kein5830/PicoTracer/写真/IMG_1227.JPG

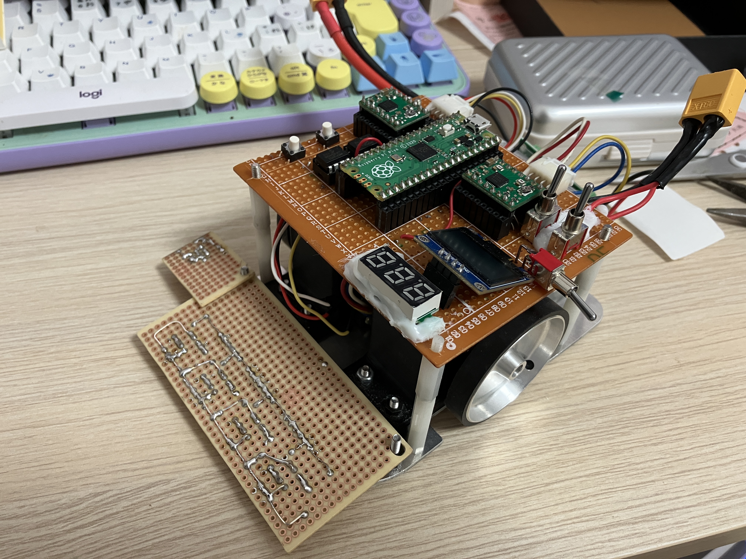
写真/IMG_1227.JPG
