kein5830/PicoTracer/部品リスト.txt

＠メイン基板
・raspi pico(マイコン)
・a4988(モータードライバ)
・MCP3002(AD変換器)×２
・トグルスイッチ（足5本）×３
・プッシュスイッチ(足４本)
・SSD1306(LCDディスプレイ　横長足４本)
・RJ-45Lanコネクタ変換基盤（横長足８本）
・モーター線用コネクタ（多分JST-XHの足４本）×２
・バッテリー電圧入力端子２本（12V,GND）
・DCDCコンバータ用端子４本(12VGND   5VGND)

＠センサー基盤
・フォトリフレクタ黒のやつ（足４本）×５個
・抵抗220Ω×5個
・抵抗10kΩ×5個

変更点

GP16、GP17：プッシュスイッチ⇒　OLEDディスプレイ
GP18、GP19：割り当てなし⇒　プッシュスイッチ

追加

ブザー
リセット用スイッチ

・仕様
電圧計は採用せず、raspi picoのAD変換機能で測定し、できればディスプレイ表示かLED３つくらいつけて一定電圧以下になったら消灯していくイメージで電圧表示
