kein5830/PicoTracer/写真/スクリーンショット 2024-08-12 18.56.13.png

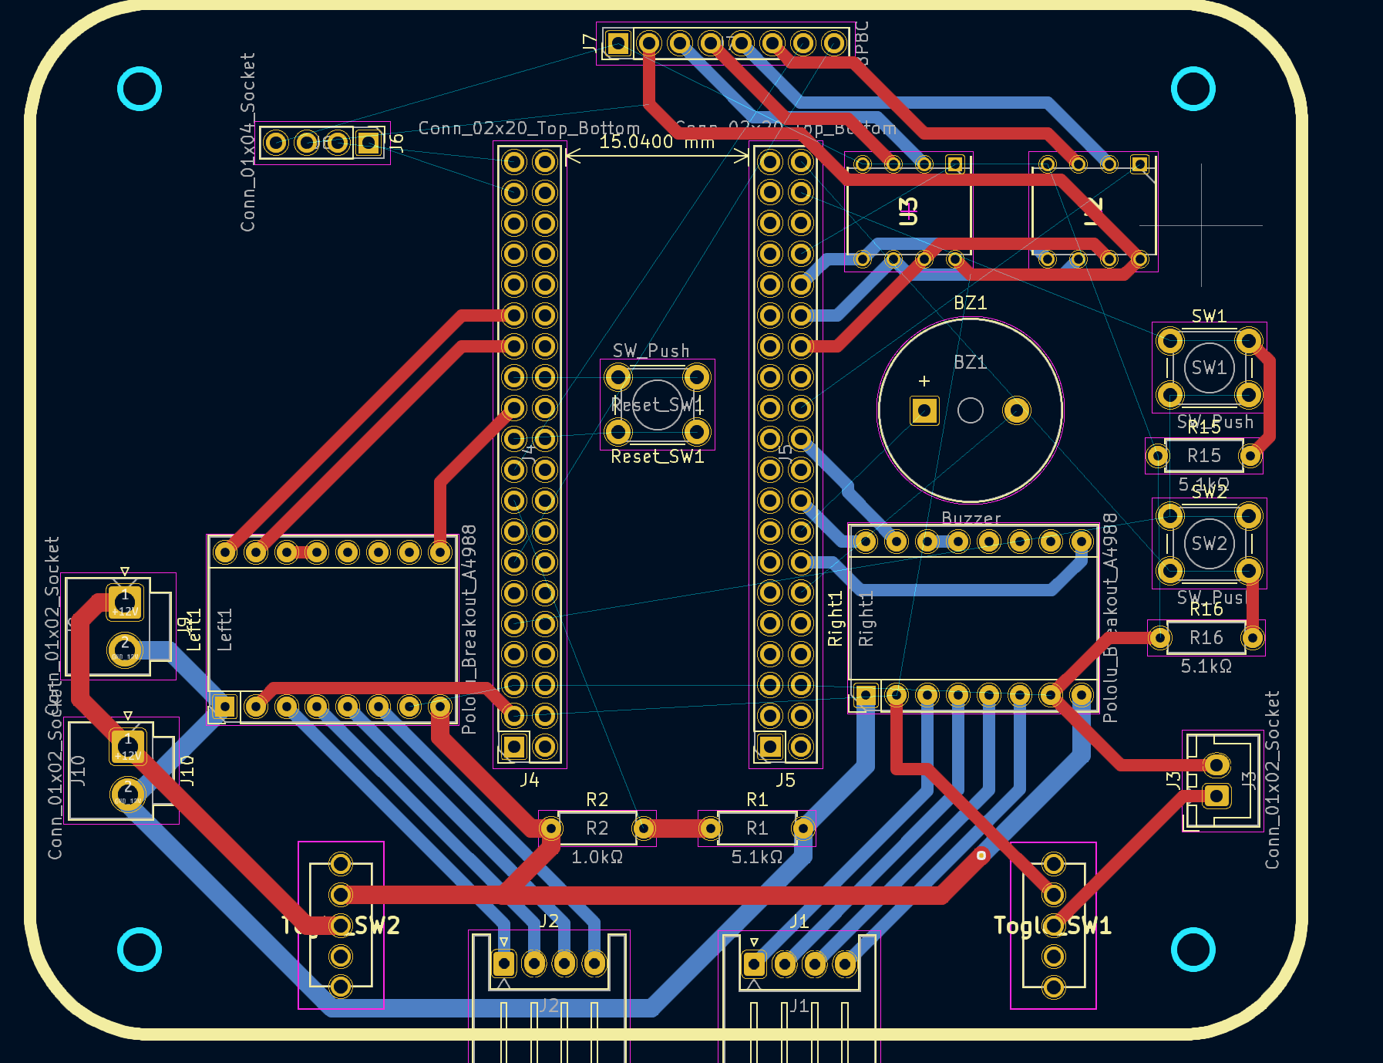
写真/スクリーンショット 2024-08-12 18.56.13.png
