kein5830/PicoTracer/写真/スクリーンショット 2024-08-13 20.15.27.png

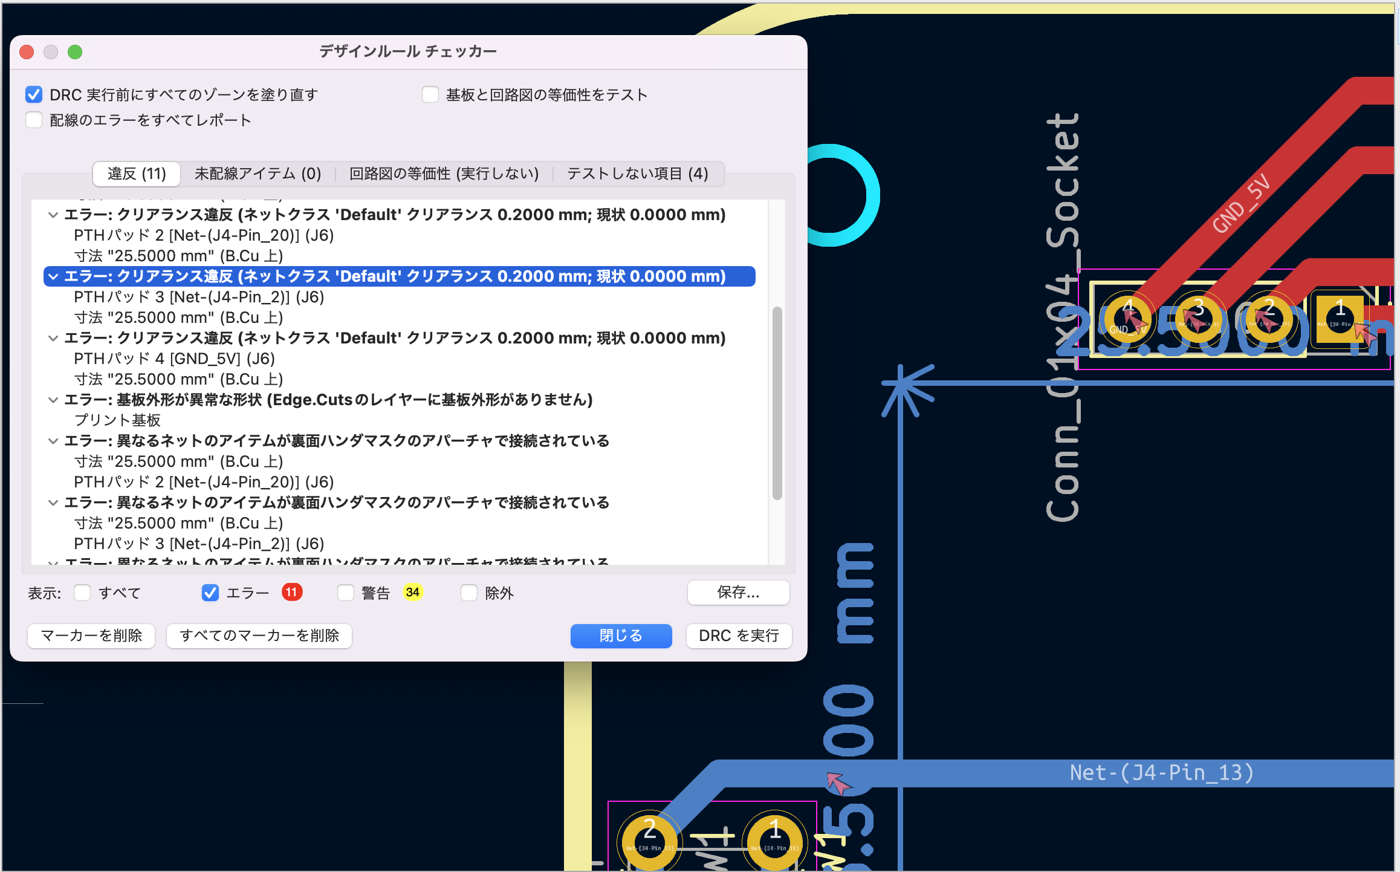
写真/スクリーンショット 2024-08-13 20.15.27.png
