kein5830/PicoTracer/circuit/PicoTracer.kicad_pcb

## KiCad design circuit/PicoTracer.kicad_pcb (2024-11-11, last stored version)

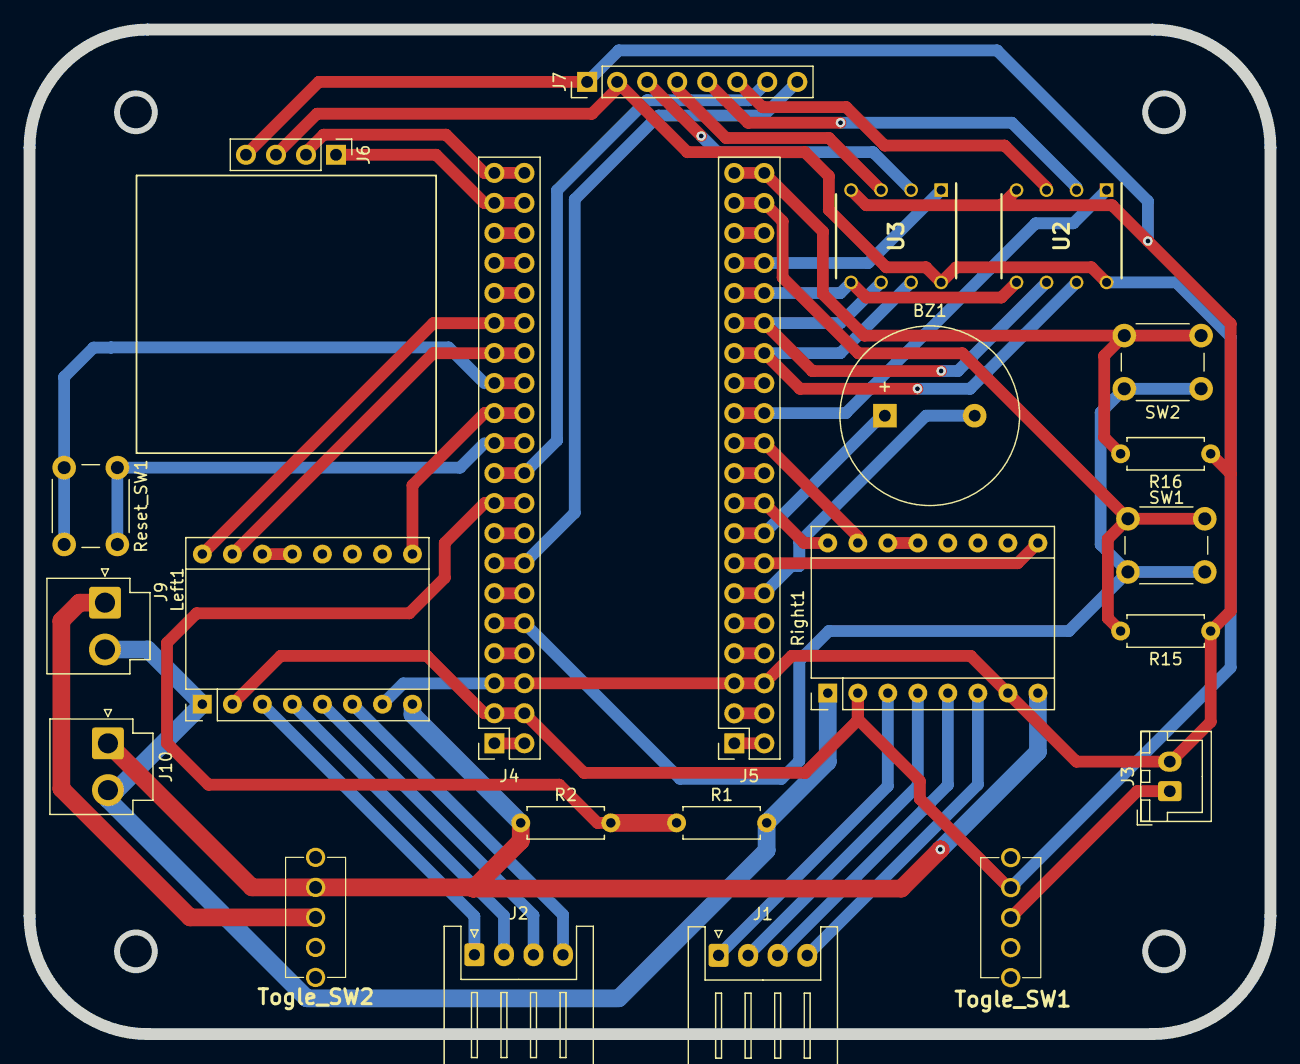
[picture p6: board PicoTracer.kicad_pcb from above]

Board: 2 copper layers, 105.0 x 85.0 mm, 23 parts (0 on the bottom side), 57 nets.

Parts:
BZ1: Buzzer; Buzzer_15x7.5RM7.6
J1, J2: Conn_01x04_Socket; JST_XH_S4B-XH-A_1x04_P2.50mm_Horizontal
J3: Conn_01x02_Socket; JST_XH_B2B-XH-A_1x02_P2.50mm_Vertical
J4, J5: Conn_02x20_Top_Bottom; PinSocket_2x20_P2.54mm_Vertical_Raspipico
J6: Conn_01x04_Socket; PinHeader_1x04_P2.54mm_Vertical
J7: 8P8C; PinHeader_1x08_P2.54mm_Vertical
J9, J10: Conn_01x02_Socket; JST_VH_B2P-VH_1x02_P3.96mm_Vertical
Left1: Pololu_Breakout_A4988; Pololu_Breakout-16_15.2x20.3mm
R1, R15, R16: 5.1kΩ; R_Axial_DIN0207_L6.3mm_D2.5mm_P7.62mm_Horizontal
R2: 1.0kΩ; R_Axial_DIN0207_L6.3mm_D2.5mm_P7.62mm_Horizontal
Reset_SW1: SW_Push; SW_PUSH_6mm_H4.3mm
Right1: Pololu_Breakout_A4988; Pololu_Breakout-16_15.2x20.3mm
SW1, SW2: SW_Push; SW_PUSH_6mm_H4.3mm
Togle_SW1, Togle_SW2: SW_SPDT; 2MS1T1B4VS2QES
U2, U3: MCP3002; DIP781W56P254L950H533Q8N

Connections:
3.3V: J4.5, J4.25, SW1.2, SW2.1
+5V: J3.1, Togle_SW1.2 (B)
+12V: J9.1, Togle_SW2.2 (B)
Clock: J5.14, J5.34, U2.7 (CLK), U3.7 (CLK)
Curve_Sensor: J4.7, J4.27, J7.8
Din: J5.16, J5.36, U2.5 (DIN), U3.5 (DIN)
Dout: J5.15, J5.35, U2.6 (DOUT), U3.6 (DOUT)
GND_5V: J3.2, J4.3, J4.23, J5.3, J5.23, J6.4, J7.1, Left1.7 (GND), R15.1, R16.1, Right1.7 (GND), U2.4 (VSS), U3.4 (VSS)
GND_12V: J9.2, J10.2, Left1.1 (GND), R1.2, Right1.1 (GND)
Goal_Sensor: J4.10, J4.30, J7.7
Left_Direction: J4.15, J4.35, Left1.16 (DIR)
Left_Enable: J4.12, J4.32, Left1.9 (~ENABLE)
Left_Step: J4.14, J4.34, Left1.15 (STEP)
unnamed: BZ1.1 (+), J5.8, J5.28
unnamed: BZ1.2 (-), J5.6, J5.26
unnamed: J1.1, Right1.3 (1B)
unnamed: J1.2, Right1.4 (1A)
unnamed: J1.3, Right1.5 (2A)
unnamed: J1.4, Right1.6 (2B)
unnamed: J2.1, Left1.3 (1B)
unnamed: J2.2, Left1.4 (1A)
unnamed: J2.3, Left1.5 (2A)
unnamed: J2.4, Left1.6 (2B)
unnamed: J4.1, J4.21
unnamed: J4.2, J4.22, J6.3, J7.2, Left1.2 (VDD), Right1.2 (VDD), Togle_SW1.1 (A), U2.8 (VDD/VREF), U3.8 (VDD/VREF)
unnamed: J4.11, J4.31, Reset_SW1.1
unnamed: J4.13, J4.33, Reset_SW1.2
unnamed: J4.16, J4.36
unnamed: J4.17, J4.37
unnamed: J4.18, J4.38
unnamed: J4.19, J4.39, J6.1
unnamed: J4.20, J4.40, J6.2
unnamed: J4.4, J4.24
unnamed: J4.6, J4.26
unnamed: J4.8, J4.28
unnamed: J4.9, J4.29, R1.1, R2.2
unnamed: J5.1, J5.21
unnamed: J5.2, J5.22
unnamed: J5.10, J5.30
unnamed: J5.13, J5.33
unnamed: J5.18, J5.38
unnamed: J5.19, J5.39, R15.2, SW1.1
unnamed: J5.20, J5.40, R16.2, SW2.2
unnamed: J5.4, J5.24
unnamed: J5.5, J5.25
unnamed: J10.1, Left1.8 (VMOT), R2.1, Right1.8 (VMOT), Togle_SW2.1 (A)
unnamed: Left1.13 (~RESET), Left1.14 (~SLEEP)
unnamed: Right1.13 (~RESET), Right1.14 (~SLEEP)
unnamed: J7.5, U2.2 (CH0)
unnamed: J7.6, U2.3 (CH1)
unnamed: J7.3, U3.2 (CH0)
unnamed: J7.4, U3.3 (CH1)
Right_Direction: J5.9, J5.29, Right1.16 (DIR)
Right_Enable: J5.7, J5.27, Right1.9 (~ENABLE)
Right_Step: J5.11, J5.31, Right1.15 (STEP)
Sel1: J5.12, J5.32, U2.1 (~CS/SHDN)
Sel2: J5.17, J5.37, U3.1 (~CS/SHDN)
