kein5830/PicoTracer/circuit/PicoTracer_Sensor.kicad_pcb

## KiCad design circuit/PicoTracer_Sensor.kicad_pcb (2024-11-11, last stored version)

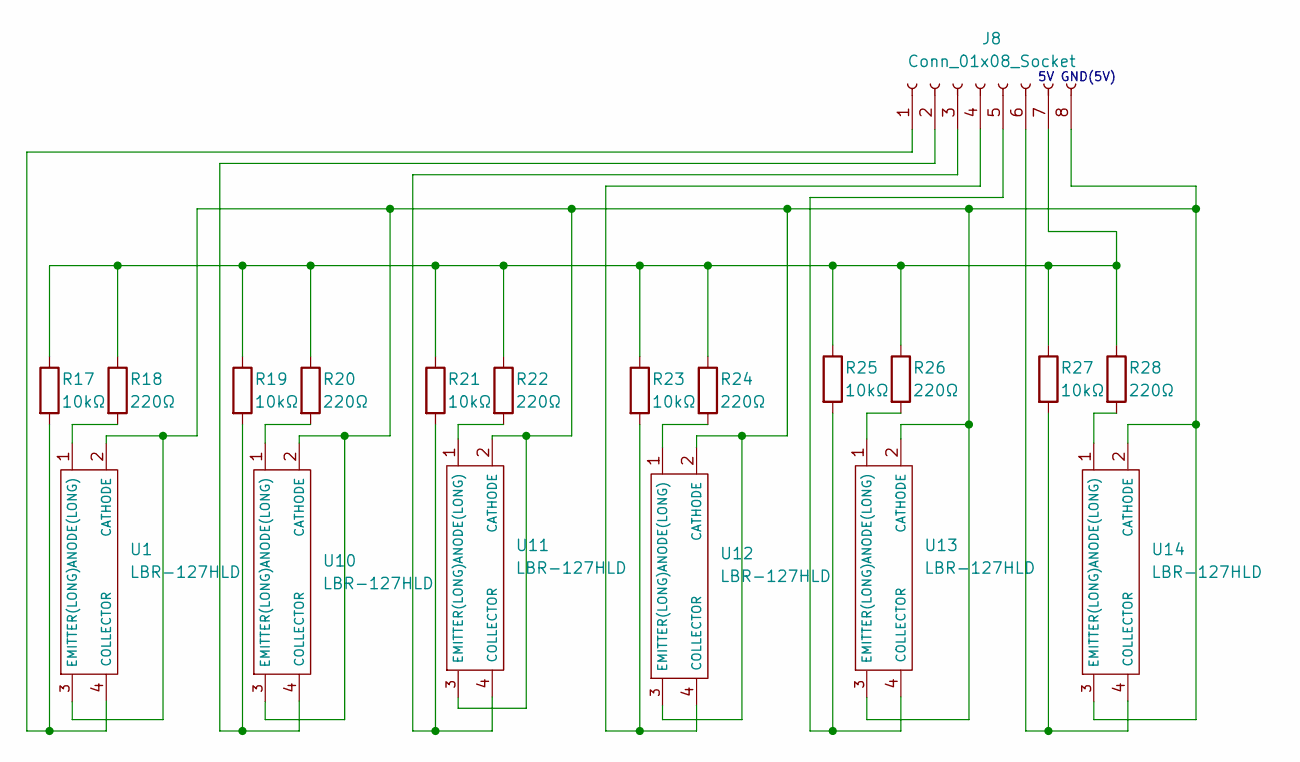
[picture p7: schematic PicoTracer_Sensor.kicad_sch]

Parts:
J8: Conn_01x08_Socket; PinSocket_1x08_P2.54mm_Vertical
R17, R19, R21, R23, R25, R27: 10kΩ; R_Axial_DIN0207_L6.3mm_D2.5mm_P7.62mm_Horizontal
R18, R20, R22, R24, R26, R28: 220Ω; R_Axial_DIN0207_L6.3mm_D2.5mm_P7.62mm_Horizontal
U1, U10, U11, U12, U13, U14: LBR-127HLD; LBR127HLD; Manufacturer_Part_Number LBR-127HLD

Connections:
unnamed: J8.1, R17.2, U1.4 (COLLECTOR)
unnamed: J8.2, R19.2, U10.4 (COLLECTOR)
unnamed: J8.3, R21.2, U11.4 (COLLECTOR)
unnamed: J8.4, R23.2, U12.4 (COLLECTOR)
unnamed: J8.5, R25.2, U13.4 (COLLECTOR)
unnamed: J8.6, R27.2, U14.4 (COLLECTOR)
unnamed: J8.7, R17.1, R18.1, R19.1, R20.1, R21.1, R22.1, R23.1, R24.1, R25.1, R26.1, R27.1, R28.1
unnamed: J8.8, U1.2 (CATHODE), U1.3 (EMITTER(LONG)), U10.2 (CATHODE), U10.3 (EMITTER(LONG)), U11.2 (CATHODE), U11.3 (EMITTER(LONG)), U12.2 (CATHODE), U12.3 (EMITTER(LONG)), U13.2 (CATHODE), U13.3 (EMITTER(LONG)), U14.2 (CATHODE), U14.3 (EMITTER(LONG))
unnamed: R18.2, U1.1 (ANODE(LONG))
unnamed: R20.2, U10.1 (ANODE(LONG))
unnamed: R22.2, U11.1 (ANODE(LONG))
unnamed: R24.2, U12.1 (ANODE(LONG))
unnamed: R26.2, U13.1 (ANODE(LONG))
unnamed: R28.2, U14.1 (ANODE(LONG))

Notes on the sheet:
GND(5V)

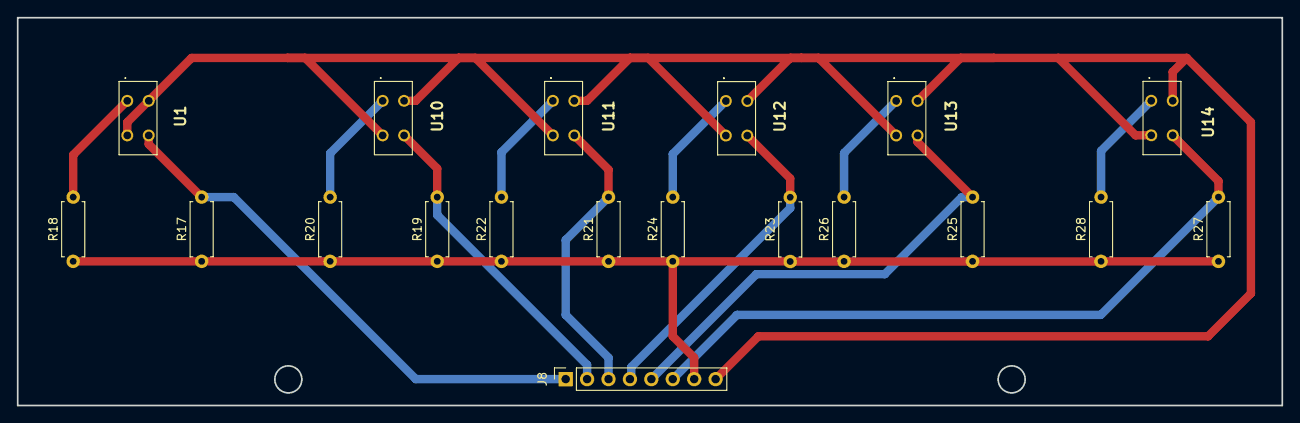
[picture p8: board PicoTracer_Sensor.kicad_pcb from above]

Board: 2 copper layers, 150.0 x 46.0 mm, 19 parts (0 on the bottom side), 14 nets.
