kein5830/PicoTracer/soucecode/picotracer/Scene3.ino

//構造体インクルード
#include "types.h"

//---------------------------------------------------------------------
//@fn　走行関数Scene3
//@brief ライントレース走行
//@param なし
//@return void
//@details　PI制御　スタート時のゆっくり加速あり+0.35 最高速度800
//---------------------------------------------------------------------
void Scene3() {
//*******************************************************************
  //メイン走行スピード、PIDのゲイン値、その他ローカル変数定義
  //*******************************************************************
  //初期
    static uint16_t tmp_distance = 0;
    static uint32_t temp_distance2 = 1;
    static int tmporary = 0;
  if(c == 0){
    //基準速度
    interval_tar = 250;
    //Pゲイン
    pgain = 0.3;
    //Dゲイン
    dgain = 0;
    //Iゲイン
    igain = 0.0;
    
    //臨時措置＃＃＃＃＃＃＃＃＃＃＃＃＃＃＃＃＃＃＃＃＃＃＃＃＃＃＃＃＃＃＃＃＃＃＃＃＃＃＃＃＃＃＃＃＃＃＃ 
    marker_distance[0] = 	5306;
    marker_distance[1] = 	386;
    marker_distance[2] = 	192;
    marker_distance[3] = 	301;
    marker_distance[4] = 	185;
    marker_distance[5] = 	292;
    marker_distance[6] = 	187;
    marker_distance[7] = 	297;
    marker_distance[8] = 	185;
    marker_distance[9] = 	422;
    marker_distance[10] = 	393;
    marker_distance[11] = 	628;
    marker_distance[12] = 	239;
    marker_distance[13] = 	213;
    marker_distance[14] = 	113;
    marker_distance[15] = 	202;
    marker_distance[16] = 	109;
    marker_distance[17] = 	206;
    marker_distance[18] = 	105;
    marker_distance[19] = 	202;
    marker_distance[20] = 	255;
    marker_distance[21] = 	182;
    marker_distance[22] = 	285;
    marker_distance[23] = 	484;
    marker_distance[24] = 	235;
    marker_distance[25] = 	502;
    marker_distance[26] = 	1351;
    marker_distance[27] = 	7;
    marker_distance[28] = 	1181;
    marker_distance[29] = 	443;
    marker_distance[30] = 	337;
    marker_distance[31] = 	312;
    marker_distance[32] = 	1145;
    marker_distance[33] = 	422;
    marker_distance[34] = 	924;
    marker_distance[35] = 	768;
    marker_distance[36] = 	1237;
    marker_distance[37] = 	353;
    marker_distance[38] = 	885;
    marker_distance[39] = 	128;
    marker_distance[40] = 	135;
    marker_distance[41] = 	138;
    marker_distance[42] = 	190;
    marker_distance[43] = 	190;
    marker_distance[44] = 	186;
    marker_distance[45] = 	481;
    marker_distance[46] = 	1008;
    marker_distance[47] = 	247;
    marker_distance[48] = 	374;
    marker_distance[49] = 	289;
    marker_distance[50] = 	283;
    marker_distance[51] = 	249;
    marker_distance[52] = 	1192;
    marker_distance[53] = 	178;
    marker_distance[54] = 	74;
    marker_distance[55] = 	979;
    marker_distance[56] = 	343;
    marker_distance[57] = 	1182;
    marker_distance[58] = 	248;
    marker_distance[59] = 	140;
    marker_distance[60] = 	141;
    marker_distance[61] = 	341;
    marker_distance[62] = 	164;
    marker_distance[63] = 	219;
    marker_distance[64] = 	901;
    marker_distance[65] = 	334;
    marker_distance[66] = 	1560;
    marker_distance[67] = 	233;
    marker_distance[68] = 	234;
    marker_distance[69] = 	186;
    marker_distance[70] = 	67;
    //臨時措置 大会時は削除する（コースの記録）＃＃＃＃＃＃＃＃＃＃＃＃＃＃＃＃＃＃＃＃＃＃＃＃＃＃＃＃＃＃＃＃＃＃＃＃＃＃＃＃＃＃＃＃＃＃＃
    //最速走行のマーカ確認
    for(int z=0;z<=first_count;z++){
      Serial.print("marker_distance：");
      Serial.println(marker_distance[z]);
    }
    c=1;
  }
  pgain = 0.3;

  //*******************************************************************
  //センサー値格納　（202412月17日に配置更新）
  //*******************************************************************
  sensorCurve = analogRead(Curve_Sensor);
  sensorLL = read_adc(ch1, SELPIN1);
  sensorL = read_adc(ch0, SELPIN1);
  sensorR = read_adc(ch1, SELPIN2);
  sensorRR = read_adc(ch0, SELPIN2);
  sensorGoal = analogRead(GOALSENSOR);

  //必要であれば
  // Serial.print(marker_distance[curve_count], DEC);
  // Serial.print(" ");
  // Serial.print(NowDistance, DEC);
  // Serial.print(" ");
  // Serial.print(temp_distance2, DEC);
  // Serial.print(" "); 
  // Serial.print(curve_count, DEC);
  // // Serial.print(" ");
  // // Serial.print(sensorRR, DEC);
  // // Serial.print(" ");
  // // Serial.print(sensorGoal, DEC);
  // Serial.println(" ");

  //*******************************************************************
  //ラインカウンタ制御  
  //*******************************************************************
  //クロスラインを検知したら、クロスフラグをON
  if (tmpc == 0 && sensorL < 300 && sensorR < 300 && sensorLL < 300 && sensorRR < 300) {
    temp_distance = NowDistance;
    cross = 1;
    tmpc = 1;
    }
  if ( tmpc == 1 && sensorLL > 700 && sensorRR > 700) {
    tmpc = 0;
  }

  //ゴールセンサが検知したらtmpフラグをON
  if (tmp == 0 && sensorGoal < 300 ){  //速度によって調整  && sensorRR > 500 && sensorLL > 500 && Curve > 800
    if(cross != 1){
      count++;
      //BUZZER入れたが音小さくて聞こえない
      tone(BUZZER,1178,100);
      // StepSW = !StepSW;
    }
    tmp = 1;
  }
  //ゴールセンサが検知しなくなったらクロスフラグを確認し、ゴールマーカーを追加するか判断
  if (tmp == 1 && sensorGoal > 700) {
    tmp = 0;
  }

  //カーブマーカー検知
  if (curve_temp == 0  && sensorCurve < 300){
      //クロスではない場合
      if(cross != 1){
        curve_count++;      
        //BUZZER入れたが音小さくて聞こえない
        tone(BUZZER,1178,100);
        }
      curve_temp = 1;
  }
  
  if (sensorCurve > 700) { 
    curve_temp = 0;
  }
  //クロス検知後から35mm進んだらおそらくゴール、カーブセンサは過ぎてるだろうからクロスフラグを戻す（誤検知する場合は調整する）
  if((NowDistance-temp_distance) >= 43){
    cross = 0;
  }

  //ゴール後処理
  if (count == 2) {
    if (b == 0) {
      //最後のマーカからゴールまでの距離を保存する
      // marker_distance[curve_count] = NowDistance - tmp_distance;
      // //タイマースタート処理
      // ITimer0.stopTimer();
      // ITimer0.attachInterrupt(100, callback0);  //自宅コースはスタートエリアが狭いため一時的に無効化し即停止するようにしている
      interval_tar = 0;
      first_count = curve_count;
      Step = 0;
    }
    b=1;
    
  }
  if (count >= 2 && interval < 10) {  //停止位置は試走会で調整
      ITimer0.stopTimer();
      ITimer1.stopTimer();
      Reset();
      Run = 0;

      tone(BUZZER,1446,1000); 
    }
  //ライン制御
  // Add_SensorL = sensorL + sensorLL;
  // Add_SensorR = sensorR + sensorRR;

  //加減速モード（基本的に800以上のところで加減速することになる。）
  if(marker_distance[curve_count] > 1000){
    pgain = 0.1;
    static bool first = 0;
    if(first == 0){
    temp_distance2 = NowDistance;
    first = 1;
    }
    if(prev_curve_count != curve_count){
      temp_distance2 = NowDistance;
    }
    // 記録されている距離ー加速モードに入ってからの距離＝400を切ったら減速していく
    tmporary =  (marker_distance[curve_count])-(NowDistance - temp_distance2);
    if(tmporary < 400){
      interval_tar = 300;
      // Serial.print("減速開始");
    }else{
      interval_tar = 999;
    }

    prev_curve_count = curve_count;
  }

  //今回の差分
  diff = (sensorL + sensorLL) - (sensorR + sensorRR) - bias;  //biasは試走会で調整

  //-50~50なら差分なしとする
  if(diff<=400 && diff>=-400){
    diff=0;
  }
  //  Serial.print("diff:");
  //  Serial.print(diff);
  sum += diff;
  //P制御
  P = diff * pgain;
  //D制御
  D = (beforediff - diff) * dgain;
  //I制御
  I = sum * igain;
  //入力速度にPID制御値を代入
  //Dを-にしてPで発生するオーバーシュートを抑える形にすることも検討
  PID_Result = P + D + I;
  // inputR = SP - (P + D + I);

 // 加減速時のみPIDの値に制限をかける
 if(pgain == 0.1){
  if(PID_Result < -200){
    PID_Result = -200;
  }
  if(PID_Result > 200){
    PID_Result = 200;
  }
 }

  //前回の差分を保存き
  beforediff = diff;

  //クロス通過時は速度を固定する
  if (sensorLL < 400 && sensorRR < 400) {
    PID_Result = 0;
  }



  //ログ保存スタートボタンを押してから
    // data_log[log_count].Curve_log = sensorCurve;
    // data_log[log_count].LL_log = curve_count;
    // data_log[log_count].L_log = NowDistance;
    // data_log[log_count].R_log = cross;
    // data_log[log_count].RR_log = temp_distance;
    // data_log[log_count].Goal_log = count;
//    data_log[log_count].R_motor_log = inputR;
//    data_log[log_count].L_motor_log = PID_Result;
    log_count++;  
}
