kein5830/PicoTracer/soucecode/picotracer/AccTable.h

unsigned short AccTable[1000]{
0,36,51,62,72,80,88,95,101,107,
113,119,124,129,134,138,143,147,152,156,
160,164,168,171,175,179,182,186,189,193,
196,199,202,205,208,212,215,217,220,223,
226,229,232,234,237,240,242,245,248,250,
253,255,258,260,263,265,268,270,272,275,
277,279,282,284,286,288,290,293,295,297,
299,301,303,305,308,310,312,314,316,318,
320,322,324,326,328,330,332,333,335,337,
339,341,343,345,347,348,350,352,354,356,
358,359,361,363,365,366,368,370,372,373,
375,377,378,380,382,383,385,387,388,390,
392,393,395,397,398,400,401,403,405,406,
408,409,411,412,414,415,417,418,420,422,
423,425,426,428,429,431,432,433,435,436,
438,439,441,442,444,445,447,448,449,451,
452,454,455,456,458,459,461,462,463,465,
466,468,469,470,472,473,474,476,477,478,
480,481,482,484,485,486,488,489,490,492,
493,494,495,497,498,499,501,502,503,504,
506,507,508,509,511,512,513,514,516,517,
518,519,521,522,523,524,525,527,528,529,
530,532,533,534,535,536,538,539,540,541,
542,543,545,546,547,548,549,550,552,553,
554,555,556,557,558,560,561,562,563,564,
565,566,568,569,570,571,572,573,574,575,
577,578,579,580,581,582,583,584,585,586,
587,589,590,591,592,593,594,595,596,597,
598,599,600,601,603,604,605,606,607,608,
609,610,611,612,613,614,615,616,617,618,
619,620,621,622,623,624,625,626,627,628,
630,631,632,633,634,635,636,637,638,639,
640,641,642,643,644,645,646,647,648,649,
650,650,651,652,653,654,655,656,657,658,
659,660,661,662,663,664,665,666,667,668,
669,670,671,672,673,674,675,676,676,677,
678,679,680,681,682,683,684,685,686,687,
688,689,690,691,691,692,693,694,695,696,
697,698,699,700,701,702,702,703,704,705,
706,707,708,709,710,711,711,712,713,714,
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
};
