kein5830/PicoTracer/soucecode/picotracer/types.h

#include <Arduino.h>
#ifndef TYPES_H
#define TYPES_H
//ログ保存用構造体定義
  typedef struct {
    //ライン検知センサ
    uint16_t Curve_log;
    uint16_t LL_log;
    uint32_t L_log;
    uint16_t R_log;
    uint32_t RR_log;
    int Goal_log;
    //モーター出力
//    uint16_t R_motor_log;
//    uint16_t L_motor_log;
   }Log;

  Log data_log[10000];

#endif
