kein5830/PicoTracer/(commit log)

2024-01-31 高速化調整：P制御＋PI制御、Pゲイン、PIゲイン調整&速度の高速化
2024-02-02 PCBデータ初回コミット
    [PicoTracer.kicad_pcb, PicoTracer.kicad_sch]
2024-02-08 Update picotracer.ino コメント追加
2024-02-15 現状不明一旦統一
2024-02-17 ファイル復帰
    [PicoTracer.kicad_pcb, PicoTracer.kicad_sch]
2024-02-17 フォルダ名変更
    [PicoTracer.kicad_pcb, PicoTracer.kicad_sch]
2024-02-17 backupあれこれ（変更なし）
    [PicoTracer.kicad_pcb, PicoTracer.kicad_sch]
2024-02-19 タイマー２つ動かしたScene4
2024-02-20 Scene4にて加速プログラム
2024-02-20 void setupにてPWMを使ったモーター制御プログラム記載（途中）
2024-02-21 wrap値とパルス周波数の関係、Duty比についてをコメントに追加、functionにwrapとパルス周波数を変換する関数追加
2024-03-02 走行終了時に再度モード選択ができるように修正（未完成）
2024-03-02 走行終了時に再度モード選択ができるように修正
2024-03-31 kicadファイル更新 部品配置
    [PicoTracer.kicad_sch]
2024-03-31 部品リスト更新
2024-04-10 ・A4988の配線追加
    [PicoTracer.kicad_sch]
2024-04-14 ・スイッチ配線 ・AD変換器電源以外の配線完了
    [PicoTracer.kicad_sch]
2024-05-20 scene5に電圧計測追加
    [PicoTracer.kicad_sch]
2024-05-23 抵抗値コメント追記
2024-05-26 電源周り追加、プッシュスイッチ追加、電圧計測回路追加、センサー回路追加
    [PicoTracer.kicad_sch]
2024-05-26 * 電源周り追加、プッシュスイッチ追加、電圧計測回路追加、センサー回路追加
    [PicoTracer.kicad_sch]
2024-06-02 pullup用抵抗を追加（未試験のため検証して動きに問題なければつなぐ）
    [PicoTracer.kicad_sch]
2024-06-03 プッシュスイッチにPullup抵抗を追加
    [PicoTracer.kicad_sch]
2024-06-28 回路図いったん完成、PCBファイルに基盤外形追加
    [PicoTracer.kicad_pcb, PicoTracer.kicad_sch]
2024-08-08 回路図：完成、配線図：配置のみ完了
    [PicoTracer.kicad_pcb, PicoTracer.kicad_sch]
2024-08-09 バージョン8.0に更新
    [PicoTracer.kicad_pcb, PicoTracer.kicad_sch]
2024-08-09 配線途中
    [PicoTracer.kicad_pcb]
2024-08-09 mac内kicad更新のため
2024-08-17 配線図完成、回路図スイッチの配線位置変更
    [PicoTracer.kicad_pcb, PicoTracer.kicad_sch]
2024-08-24 ・配線完了
    [PicoTracer.kicad_pcb]
2024-09-09 ・メイン基板 最終版
    [PicoTracer.kicad_pcb]
2024-09-09 sensor基盤回路図：完成、配線図：部品配置まで
    [PicoTracer_Sensor.kicad_pcb, PicoTracer_Sensor.kicad_sch]
2024-09-09 配線図：配線まで完了 ガーバーファイル出すときに水色の線を出さないよう注意！
    [PicoTracer_Sensor.kicad_pcb]
2024-09-17 配膳図、回路図の追加
2024-09-24 ピン割り当て変更
2024-09-25 ブザーを鳴らすためのtone関数追加
2024-09-29 ブザー鳴らす処理追加
2024-09-29 SSD1306表示コード実装
2024-10-01 電圧読み取り、表示部更新（未チェック）
2024-10-01 デバッグ用Serialprint追加
2024-10-06 ・電圧測定計算追加
2024-10-14 ・Scene5のコードをモーター、センサーのテスト用に修正
2024-10-15 ・コメントなど一部修正
2024-10-20 ・ADコンバータのピン番号修正、センサー配置の修正
2024-10-22 ・コード共有のため
2024-10-30 九州大会調整結果＆ずれによるセンサー値の変化を計測するソースコード追加（scene5）
2024-11-11 code share 一旦虚っゆう
2024-11-11 PicoTracer-backupsファイルを管理外に変更 センサー、メイン配線図ファイル修正、その他ファイル更新
    [PicoTracer.kicad_pcb, PicoTracer_Sensor.kicad_pcb]
2024-11-18 現状コード共有 センサー値を配列に保存する仕組みのj検証中
2024-11-19 update/コメント修正（途中）、関数削除
    関数などのコメントをわかりやすいように統一（途中 完了次第再コミット）
    必要ないScene6の削除とscene5を完全にコメントアウト
    [function.ino, picotracer.ino]
2024-11-20 update/コメント修正(完了)、一部変数名の変更\n関数のコメントを統一
2024-11-24 update:コメント修正、待機モード中の処理を定周期処理＋イベント処理に変更
    ・変数の説明などのコメントを見やすいよう修正
    ・プッシュスイッチ待機、ディスプレイ更新、バッテリー電圧取得処理を、loop()へのべた書きからmillis()を使った定周期処理に変更
2024-12-01 update/実行モード中のWhileLoop廃止、コメント修正
    ・ディスプレイ表示部のコメントを削除
    ・実行モード時に、ディスプレイ更新、電圧取得関数を定周期実行しないように変更
    ・実行関数のWhileLoopを廃止して、メインLoopで実行するように修正。それに伴い、終了時に待機モードに移行するように修正
    ・ディスプレイのモード表示が２つから４つに増えるに伴い、引数をboolから、uint8_tに変更
    ・switch case 内に実行関数を登録していないものも追加し、ディスプレイに「No Action」と表示するよう変更
    ・0~9以外の番号が入力さ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
    [function.ino, picotracer.ino]
2024-12-01 ブランチを枝分かれさせるため用
2024-12-01 fix/PWM停止忘れによるバグ修正、Reset()内の処理修正、Scene4用変数をグローバル変数に変更、実行中のsw1を無効化
    ・各Sceneにより、PWMを開始した後に、待機モードに遷移し、Scene5以降の入っていないSceneに遷移した場合に以前のSceneのPWMが実行されたままで、モーターが回ってしまうバグの修正
    ・Reset()内の、Run=0という処理を削除
    ・Scene４のSpeed変数をグローバル変数に変更し、リセット時に加速したスピードをリセットできるように修正
    ・実行中にsw1を押すことで、Sceneが切り替わってしまうバグを修正
    [function.ino, picotracer.ino]
2024-12-02 fix/Scene3でリセットがかからないバグ修正、update/実行モードを定周期実行に変更、Scene2～４の加速を＋１ずつに変更、関数のコメントの修正
    ・Scene3において終了時にリセット関数を入れていないことによるバグ修正（Reset()の追加）
    ・実行モードのswitch caseを定周期実行に変更（現在は10ms周期 遅延はなさげ）
    ・PWM関数の引数がuint16の型なのに対して、floatの値を入れることにより、動作がおかしい部分が存在していたため、小数点での加速を廃止し、＋１に統一→今後は別の仕組みで加速制御の実装を予定
    ・関数のコ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
    [function.ino, picotracer.ino]
2024-12-08 基盤ファイルをgit管理しないよう変更
    [PicoTracer.kicad_pcb, PicoTracer.kicad_sch, PicoTracer_Sensor.kicad_pcb, PicoTracer_Sensor.kicad_sch]
2024-12-08 基盤ファイルをgit管理から削除
    [PicoTracer.kicad_pcb, PicoTracer.kicad_sch, PicoTracer_Sensor.kicad_pcb, PicoTracer_Sensor.kicad_sch]
2024-12-15 add:ログ用構造体の定義
    ・ログ取得用構造体を定義
    ・定周期ごとに値を取得する関数の定義（途中）
2024-12-19 update/types.hファイル追加、ログ保存用構造体作成、Scene５でシリアルプリントによるログ出力
    ・ログ保存機能を追加したかったが、シリアル出力までしかできず、Flashへの保存機能は未実装
    ・ブザー変更によるtone関数の追加
    ・バッテリー電圧測定の計算値を変更
2025-02-04 update/一部Sceneの古いセンサの入力配置修正
    一部Sceneの古いセンサの入力配置を修正（chとSELPIN1,2）
    大会時に考えていた内容についてコメント追記
2025-02-04 fix/謎の全角スペースを削除\n\n謎の全角スペースが混入しておりコンパイルが通らなかったため修正
2025-02-15 update:取得項目削減＆ログ一時保存用配列サイズ変更、Flashメモリ書き込み処理（途中）
    3分間ログを保存できるように配列サイズを10000 -> 18500に変更 10ms周期なら185秒保存可能
    RAMサイズ上モーター出力値は取得しない（PIDの計算から求めることは可能）
    Flashメモリに書き込む処理を追加しようとしたが、大会までの残り時間上途中
2025-02-15 fix:USB電源の際にAD変換器、ディスプレイの初期設定を無効化 update:buzzerが周波数によって音階を変化するように修正
    USB電源でマイコンを動作させている時にAD変換器のHIGH出力により3.3Vラインに2Vほど電圧がかかることがあり、その処置（3.3Vを入れて入れば問題なし）
    ブザーを変更したためarduinoのtone関数を利用
    [picotracer.ino]
2025-02-15 update:センサー回路変更によるAD変換器引数の修正
    AD変換器のchとCSピン配置修正
2025-02-15 update:Scene５にセンサー値チェック用関数追加、イベント処理のScene番号遷移処理修正
    Scene５にセンサー値をSerialprintに出力する処理を追加
    Scene番号遷移のイベントを待機モード中にしか遷移させないように修正
    それに伴い、実行モード中のSW1スイッチを検知できるように修正（もともとはScene番号が実行中に遷移しないように無効化していた）
    [function.ino, picotracer.ino]
2025-02-15 fix:あるSceneを実行した後に、別のSceneを実行すると前のSceneが残っている問題の修正
    あるSceneを実行し、停止した時にPWMの出力を停止しているはずだが、待機中もオンになっており、実行時にモーター電源をオンにした時に一瞬動いてしまう
    →待機中ずっとPWMをOFFにする処理を実行
2025-02-15 update:スタート、ゴール時にブザーを追加、センサー反応時にもコメントアウトしているが追加
    ブザー音追加 センサー反応時にも追加したが、モーターがうるさすぎて聞こえないのでいったんコメントアウト状態にしている。
2025-02-16 Update:左右センサーの合計値をPID制御する仕様に変更 ゲインの調整 センサー値のバイアスを追加
    ログ取得ブランチをマージするために一時的にコミット
2025-03-09 update:Scene1,Scene2全日本変更
    updata:速度、ゲイン、センサーごとの誤差調整
    updata:マーカー検知センサー値の調整
    updata:ログ保存用構造体の拡張、センサー値以外の値を取れるように型の修正
    updata:Scene1,Scene2の速度変更
    [function.ino, picotracer.ino, types.h]
2025-03-16 fix:Hzwrap()のWrap値上限の設定
    Wrap値がuint16の上限を超えないよう修正
2025-04-07 update:micros()を使用したモータ動作システムの導入、距離計測関数追加
    picotracer.inoにmicros()から一定周期で関数を呼び出す仕組みを作成し、パルスを生成する仕組みの導入（定周期実行処理と同じ）
    function.inoに上記処理によって求められるステップ数から距離を計算する関数を追加
2025-04-17 ・テストコミット Gitのテストのため、コメントを追加し変更した。 実際に変更を加えるときに削除する。
2025-05-18 update:Scene2,3コメントアウト、Curveマーカー用センサー値取得変数の名前修正、Curveマーカー検知機能追加(Scene0)、モーター回転用の周期変数名変更
    前回のupdate分：距離取得関数追加
    今回のupdate分：
    Scene2、３ 一旦使用しないためコメントアウト
    Curveマーカーセンサ値を保存する変数名を変更 Curve -> sensorCurve
    Curveマーカー検知機能を追加 ただしクロスラインとの切り分け方法を次のバージョンで修正するため、この部分も修正する予定
    モーター回転用の周期変数名変更 interval1 -> intervalR interval2 -> intervalL
    その他 コメ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
    [function.ino, picotracer.ino]
2025-06-08 ・update：スタートからの距離計測機能、ゴールとカーブマーカのカウント方法変更、コメント修正
    距離計測機能：実行モードに遷移してから、10msごとにGet_Distance()を実行し、距離を取得する。NowDistanceを一時変数に保存することで、その地点からの距離を取得できる、はず。
    ゴール、カーブマーカ取得方法変更：これまでは、マーカセンサでのカウント値からクロス分を引く方法だったが、クロスを検知したら、35mmはクロスフラグをONにし、その間にマーカセンサが反応してもカウントしないように変更
2025-06-09 update:関数のファイル分割
    関数の持つ機能ごとにファイルを分け見やすくした。
    詳細onenoteの「関数ファイル分け」ページ参照
2025-06-29 update:Scene0にマーカごとの距離取得機能を追加、その他コメントの修正など
    Scene0にスタートからゴールまでの各マーカー間の距離をmarker_distance[]に記録する機能を追加（配列は100個までなので、コースによってはオーバーする可能性あり）
    Logにマーカのカウントなどを出力するように修正
2025-11-09 add/加速テーブル追加
    ・加減速走行実装のため、加速テーブルを追加（加速テーブルはマイクロマウスサンプルを参考に作成）
2025-11-09 update/Scene4：テスト用のモータ動作の変更Scene5：不要部分の削除やみたい変数の追加などScene6：無効化部分の解除
    ・Scene4：モーターの動作を加速テーブルをベースにした制御に変更したため、それの対応を実施
    ・Scene5：センサー試験において必要ない処理の削除とみたい変数の追加
    ・Scene6：ログ出力機能のコメント解除とログ出力中にモーターが回転しないような処理の追加
2025-11-09 update/制御方式変更による基準速度の変更、ゴールマーカ検知後の動作変更、不要コメントの削除など
    ・ゴールマーカ検知後にタイマー割り込みで時間で止めていたものから、マーカー検知後に速度0まで減速する処理に変更
2025-11-09 add/マーカを元に加減速走行する機能の実装、不要コメントの削除など
    ・１走目でカーブマーカ間の走行距離を取得し、２走目のマーカー間で1000mm以上の距離であれば、加減速を実施するように処理
2025-11-09 add/センサー値の正規化の動作確認処理追加
    ・センサー値の正規化処理が動作しているか試すために処理を追加したが、走行では使用していない
2025-11-09 add/Scene1の加減速走行をコピーし、マーカー間の距離を手打ちで追加したモード
    ・加減速走行の練習のために追加（本番では使用せず）
2025-11-09 update/バッテリー電圧更新、プッシュスイッチの検知、走行距離計測機能を、メインループの擬似タイマー処理から、タイマー割り込み関数に移動
    ・もともとメインループで擬似タイマー割り込みして実装していた機能をタイマー割り込み関数を使用した処理に変更、それにより走行時にタイマーの停止、リセット時にタイマーを再開する処理を追加
2025-11-09 update/タイマー処理の追加、必要な変数の追加、モーター制御方法の変更、定周期処理の変更など
    ・定周期処理で追加していたバッテリー電圧計測、プッシュスイッチ検知、走行距離計測機能をタイマーライブラリに移動
